hkepc-project/Noise-Meter/hardware/README.md

This repository contains a Noise Meter project from the following link:

http://www.hkepc.com/forum/viewthread.php?fid=146&tid=2419038&extra=page%3D1

The hardware and associated materials (excluding any software) are provided under a [CC BY-SA 4.0](https://creativecommons.org/licenses/by-sa/4.0/) license.
