hkepc-project/Noise-Meter/(list of files, cad)

Other CAD files:
software/PIC/Noise Meter/dist/default/production/Noise_Meter.production.obj
