hkepc-project/Noise-Meter/hardware/Noise Meter.kicad_pcb

## KiCad design hardware/Noise Meter.kicad_pcb (2018-01-29)

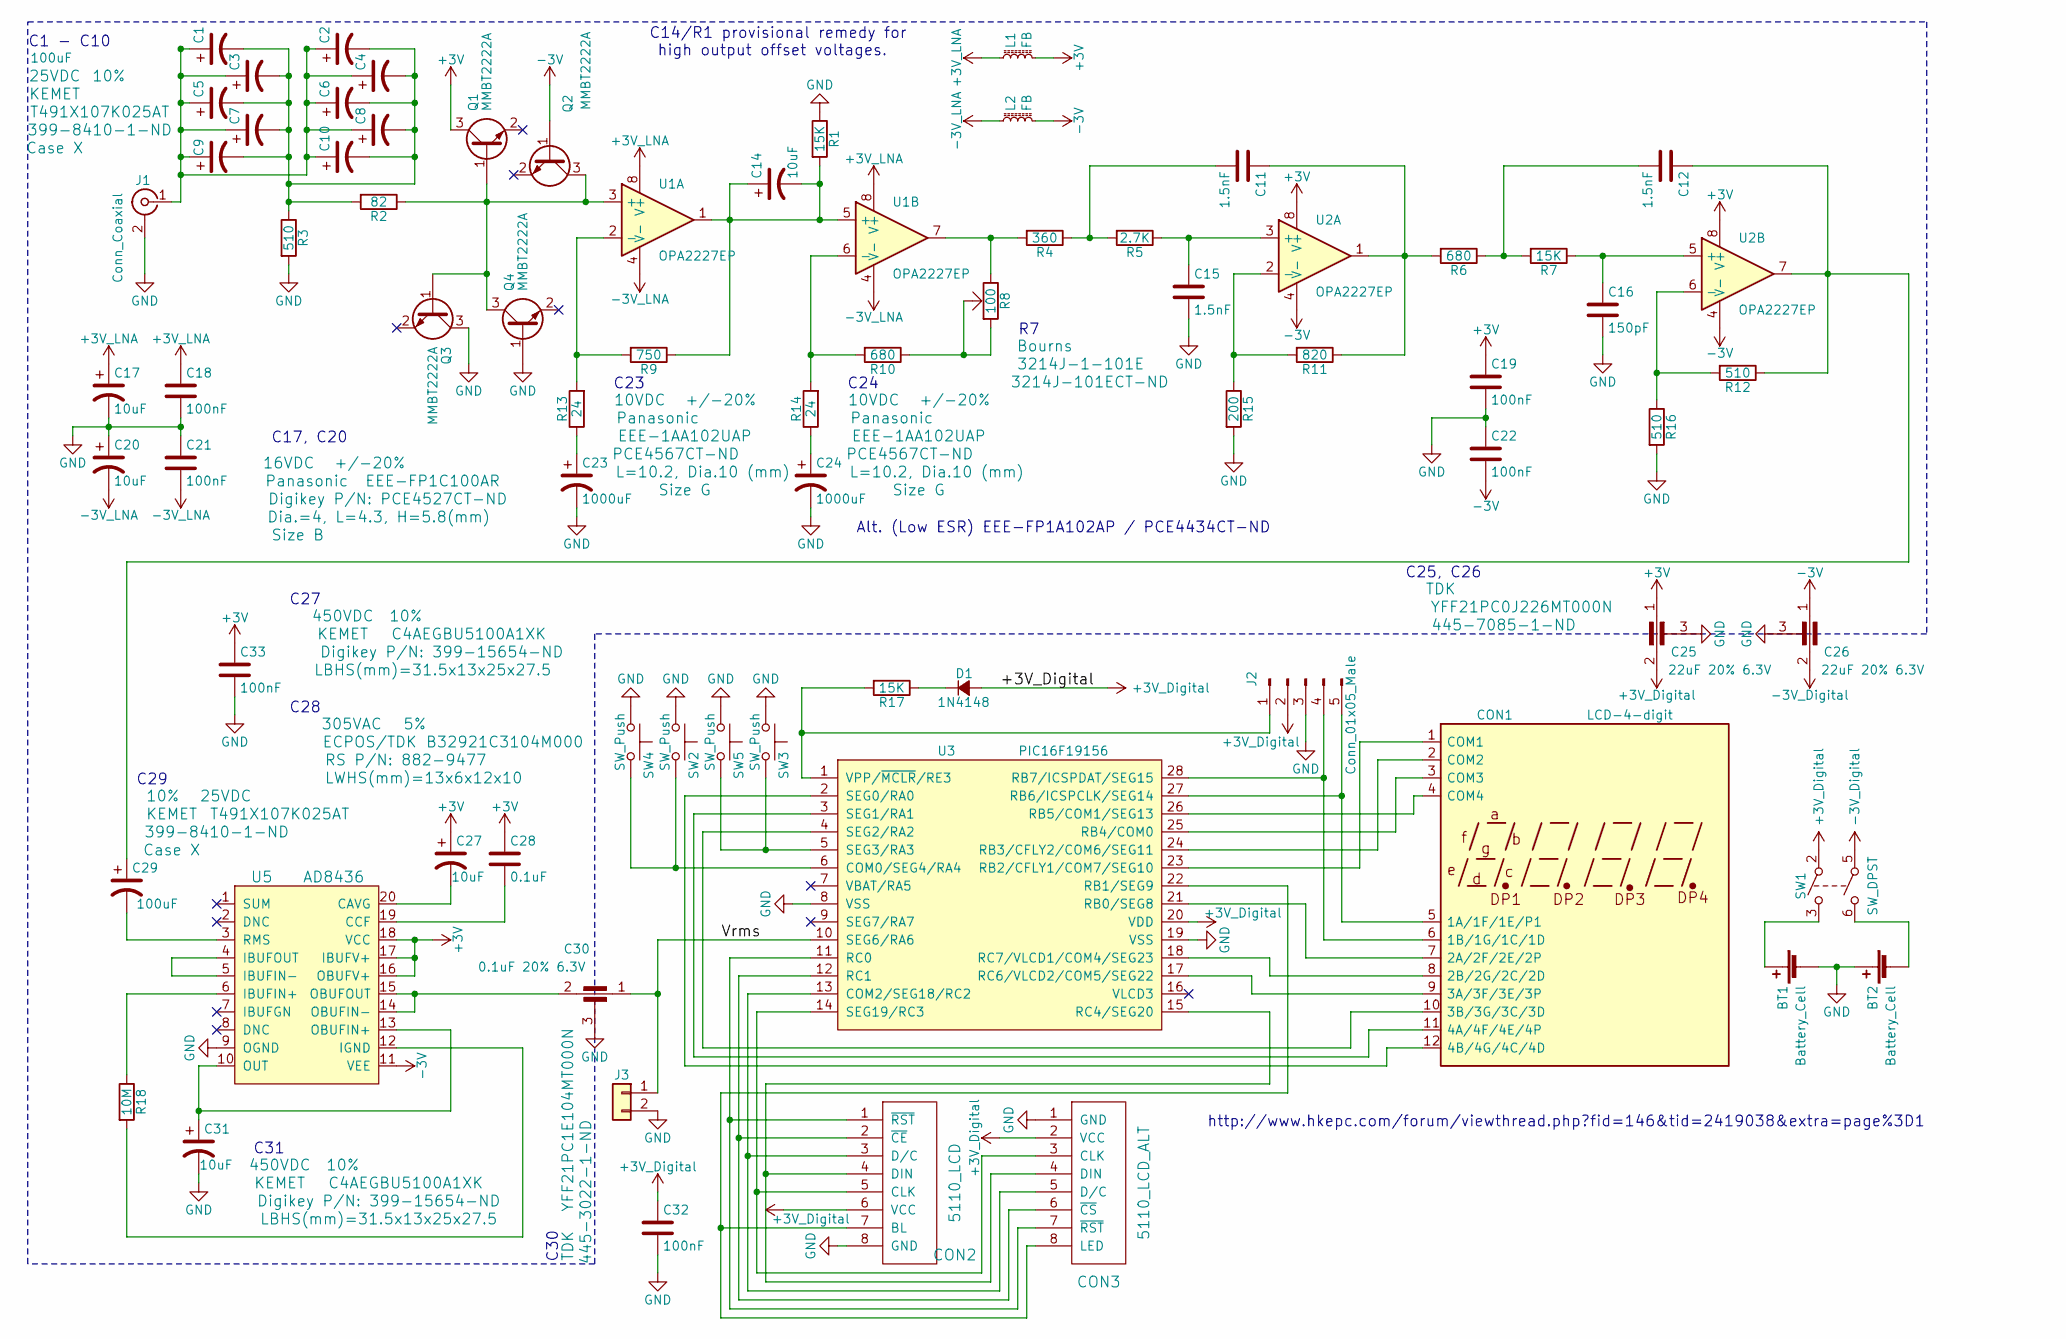
[picture p1: schematic Noise Meter.sch]

Parts:
BT1, BT2: Battery_Cell; Keystone_1058_1x2032-CoinCell
C1, C2, C3, C4, C5, C6, C7, C8, C9, C10, C29: 100uF; CP_Tantalum_Case-X_EIA-7343-43_Hand; Tolerance 10%; Voltage 25VDC; Manufacturer P/N T491X107K025AT; Digikey P/N 399-8410-1-ND
C11, C12, C15: 1.5nF; C_0603_HandSoldering
C14, C17, C20: 10uF; CP_Elec_4x4.5; Voltage 16VDC; Tolerance +/-20%; Manufacturer P/N EEE-FP1C100AR; Digikey P/N Digikey P/N: PCE4527CT-ND
C16: 150pF; C_0603_HandSoldering
C18, C19, C21, C22, C32, C33: 100nF; C_0603_HandSoldering
C23, C24: 1000uF; CP_Elec_10x10.5; Voltage 10VDC; Tolerance +/-20%; Manufacturer P/N EEE-1AA102UAP; Digikey P/N PCE4567CT-ND
C25, C26: 22uF 20% 6.3V; Feedthrough_C_0805_HandSoldering; Manufacturer P/N YFF21PC0J226MT000N; Digikey P/N 445-7085-1-ND
C27, C31: 10uF; C_Rect_L31.5mm_W13.0mm_P27.50mm_MKS4; Tolerance 10%; Voltage 450VDC; Manufacturer P/N C4AEGBU5100A1XK; Digikey P/N Digikey P/N: 399-15654-ND
C28: 0.1uF; C_Rect_L13.0mm_W6.0mm_P10.00mm_FKS3_FKP3_MKS4; Voltage 305VAC; Tolerance 5%
C30: 0.1uF 20% 6.3V; Feedthrough_C_0805_HandSoldering; Manufacturer P/N YFF21PC1E104MT000N; Digikey P/N 445-3022-1-ND
CON1: LCD-4-digit; 4-digit-LCD-footprint
CON2: 5110_LCD; 5110
CON3: 5110_LCD_ALT; 5110-Alt
D1: 1N4148; D_SOD-123
J1: Conn_Coaxial; SMA-CONN
J2: Conn_01x05_Male; Pin_Header_Angled_1x05_Pitch2.54mm
J3: Conn_01x02; Pin_Header_Angled_1x02_Pitch2.54mm
L1, L2: FB; L_0805
Q1, Q2, Q3, Q4: MMBT2222A; SOT-23
R1, R7, R17: 15K; R_0603_HandSoldering
R2: 82; R_0603_HandSoldering
R3, R12, R16: 510; R_0603_HandSoldering
R4: 360; R_0603_HandSoldering
R5: 2.7K; R_0603_HandSoldering
R6, R10: 680; R_0603_HandSoldering
R8: 100; Potentiometer_Trimmer_Bourns_3214J; Manufacturer P/N 3214J-1-101E; Digikey P/N 3214J-101ECT-ND
R9: 750; R_0603_HandSoldering
R11: 820; R_0603_HandSoldering
R13, R14: 24; R_0603_HandSoldering
R15: 200; R_0603_HandSoldering
R18: 10M; R_0603_HandSoldering
SW1: SW_DPST; SW_CuK_JS202011AQN_DPDT_Angled
SW2, SW3, SW4, SW5: SW_Push; SW_SPST_B3SL-1002P
U1, U2: OPA2227EP; SOIC-8-N
U3: PIC16F19156; SSOP-28_5.3x10.2mm_Pitch0.65mm
U5: AD8436; SSOP-20

Connections:
+3V: C19.1, C25.1, C27.1, C28.1, C33.1, L1.2, Q1.3 (C), U2.8 (V+), U5.16 (OBUFV+), U5.17 (IBUFV+), U5.18 (VCC)
+3V_Digital: C25.2, C32.1, CON2.6 (VCC), CON3.2 (VCC), D1.2 (A), J2.2, SW1.2, U3.20 (VDD)
+3V_LNA: C17.1, C18.1, L1.1, U1.8 (V+)
-3V: C22.2, C26.1, L2.2, Q2.1 (B), U2.4 (V-), U5.11 (VEE)
-3V_Digital: C26.2, SW1.5
-3V_LNA: C20.2, C21.2, L2.1, U1.4 (V-)
/Vrms: C30.1, J3.1, U3.10 (SEG6/RA6)
GND: BT1.2 (-), BT2.1 (+), C15.2, C16.2, C17.2, C18.2, C19.2, C20.1, C21.1, C22.1, C23.2, C24.2, C25.3, C26.3, C30.3, C31.2, C32.2, C33.2, CON2.8 (GND), CON3.1 (GND), J1.2 (Ext), J2.3, J3.2, Q3.3 (C), Q4.1 (B), R1.1, R3.2, R15.2, R16.2, SW2.1, SW3.1, SW4.1, SW5.1, U3.8 (VSS), U3.19 (VSS), U5.9 (OGND)
unnamed: BT1.1 (+), SW1.3
unnamed: BT2.2 (-), SW1.6
unnamed: C1.1, C2.1, C3.1, C4.1, C5.1, C6.1, C7.1, C8.1, C9.1, C10.1, J1.1 (In)
unnamed: C1.2, C2.2, C3.2, C4.2, C5.2, C6.2, C7.2, C8.2, C9.2, C10.2, R2.2, R3.1
unnamed: C11.1, R6.2, R11.1, U2.1
unnamed: C11.2, R4.1, R5.2
unnamed: C12.1, C29.1, R12.1, U2.7
unnamed: C12.2, R6.1, R7.2
unnamed: C14.1, C14.2, R1.2, R9.1, U1.1, U1.5 (+)
unnamed: C15.1, R5.1, U2.3 (+)
unnamed: C16.1, R7.1, U2.5 (+)
unnamed: C23.1, R13.1
unnamed: C24.1, R14.1
unnamed: C27.2, U5.20 (CAVG)
unnamed: C28.2, U5.19 (CCF)
unnamed: C29.2, U5.3 (RMS)
unnamed: C30.2, U5.14 (OBUFIN-), U5.15 (OBUFOUT)
unnamed: C31.1, U5.10 (OUT), U5.13 (OBUFIN+)
unnamed: CON1.1 (COM1), U3.23 (RB2/CFLY1/COM7/SEG10)
unnamed: CON1.2 (COM2), U3.24 (RB3/CFLY2/COM6/SEG11)
unnamed: CON1.3 (COM3), U3.25 (RB4/COM0)
unnamed: CON1.4 (COM4), U3.26 (RB5/COM1/SEG13)
unnamed: CON1.5 (1A/1F/1E/P1), J2.5, U3.27 (RB6/ICSPCLK/SEG14)
unnamed: CON1.6 (1B/1G/1C/1D), J2.4, U3.28 (RB7/ICSPDAT/SEG15)
unnamed: CON1.7 (2A/2F/2E/2P), U3.21 (RB0/SEG8)
unnamed: CON1.8 (2B/2G/2C/2D), U3.18 (RC7/VLCD1/COM4/SEG23)
unnamed: CON1.9 (3A/3F/3E/3P), U3.17 (RC6/VLCD2/COM5/SEG22)
unnamed: CON1.10 (3B/3G/3C/3D), U3.4 (SEG2/RA2)
unnamed: CON1.11 (4A/4F/4E/4P), U3.3 (SEG1/RA1)
unnamed: CON1.12 (4B/4G/4C/4D), U3.2 (SEG0/RA0)
unnamed: CON2.1 (~RST), CON3.7 (~RST), U3.11 (RC0)
unnamed: CON2.2 (~CE), CON3.6 (~CS), U3.12 (RC1)
unnamed: CON2.3 (D/C), CON3.5 (D/C), U3.13 (COM2/SEG18/RC2)
unnamed: CON2.4 (DIN), CON3.4 (DIN), U3.15 (RC4/SEG20)
unnamed: CON2.5 (CLK), CON3.3 (CLK), U3.14 (SEG19/RC3)
unnamed: CON2.7 (BL), CON3.8 (LED), U3.22 (RB1/SEG9)
unnamed: D1.1 (K), R17.1
unnamed: J2.1, R17.2, U3.1 (VPP/~MCLR~/RE3)
unnamed: Q1.1 (B), Q2.3 (C), Q3.1 (B), Q4.3 (C), R2.1, U1.3 (+)
unnamed: R4.2, R8.1, U1.7
unnamed: R8.2, R8.3, R10.1
unnamed: R10.2, R14.2, U1.6 (-)
unnamed: R11.2, R15.1, U2.2 (-)
unnamed: R12.2, R16.1, U2.6 (-)
unnamed: R9.2, R13.2, U1.2 (-)
unnamed: R18.1, U5.6 (IBUFIN+)
unnamed: R18.2, U5.12 (IGND)
unnamed: SW2.2, SW4.2, U3.6 (COM0/SEG4/RA4)
unnamed: SW3.2, SW5.2, U3.5 (SEG3/RA3)
unnamed: U5.4 (IBUFOUT), U5.5 (IBUFIN-)

Notes on the sheet:
C27
C28
C29
Alt. (Low ESR) EEE-FP1A102AP / PCE4434CT-ND
C17, C20
C31
C24
C23
C25, C26
C30
C1 - C10
C14/R1 provisional remedy for high output offset voltages.
http://www.hkepc.com/forum/viewthread.php?fid=146&tid=2419038&extra=page%3D1

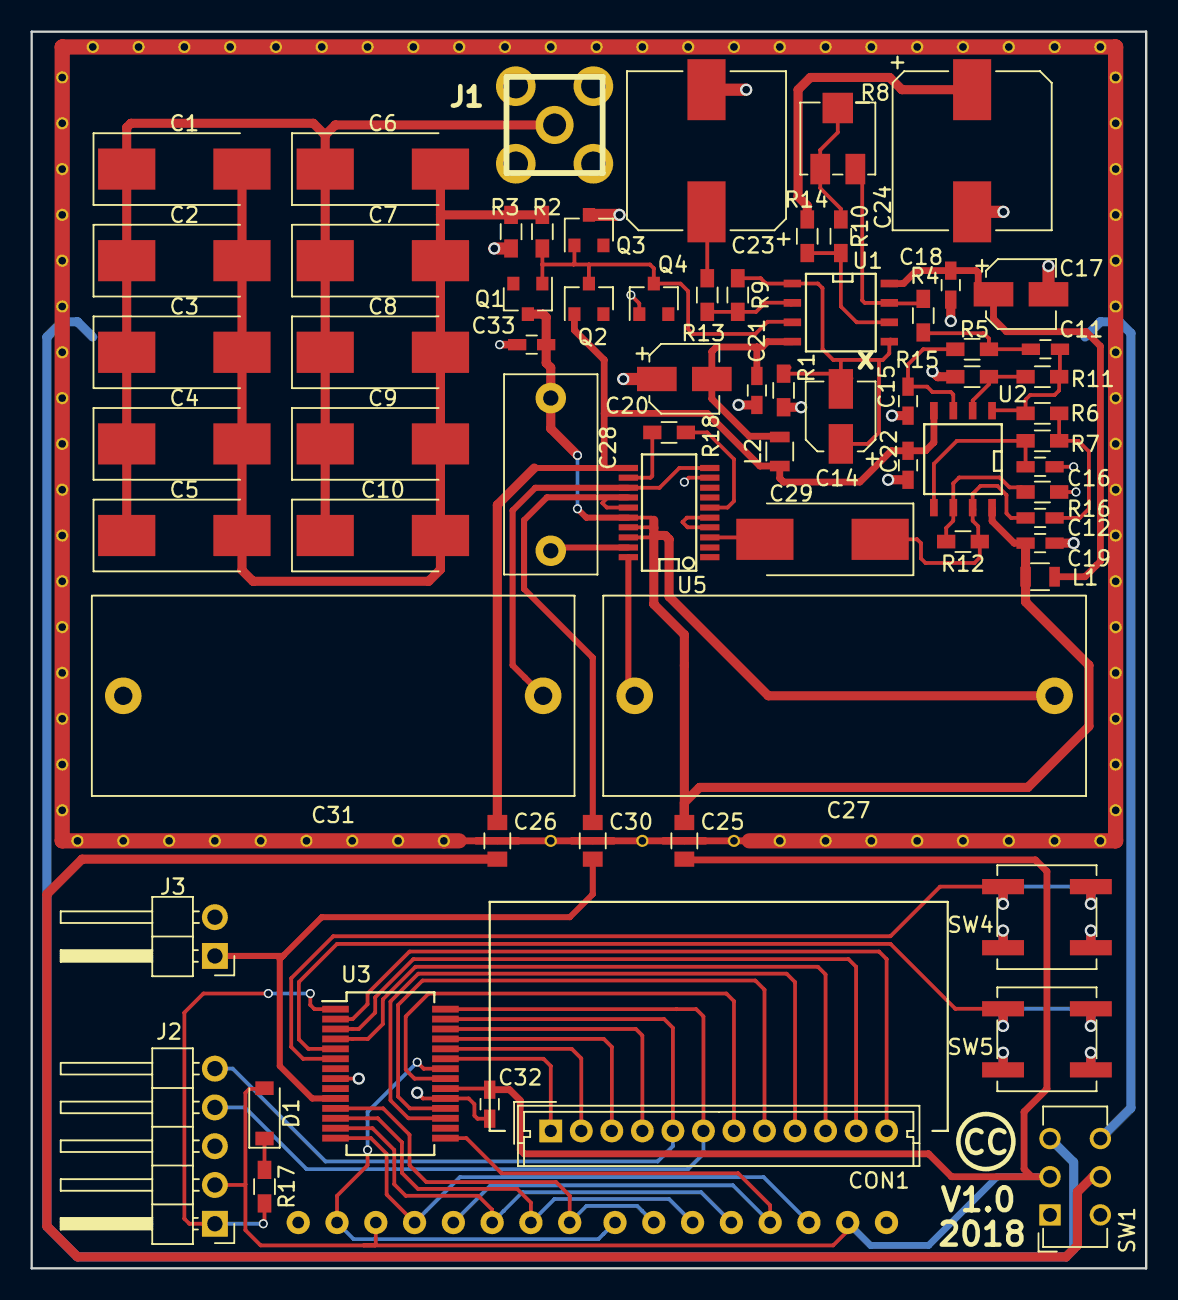
[picture p2: board Noise Meter.kicad_pcb from above]

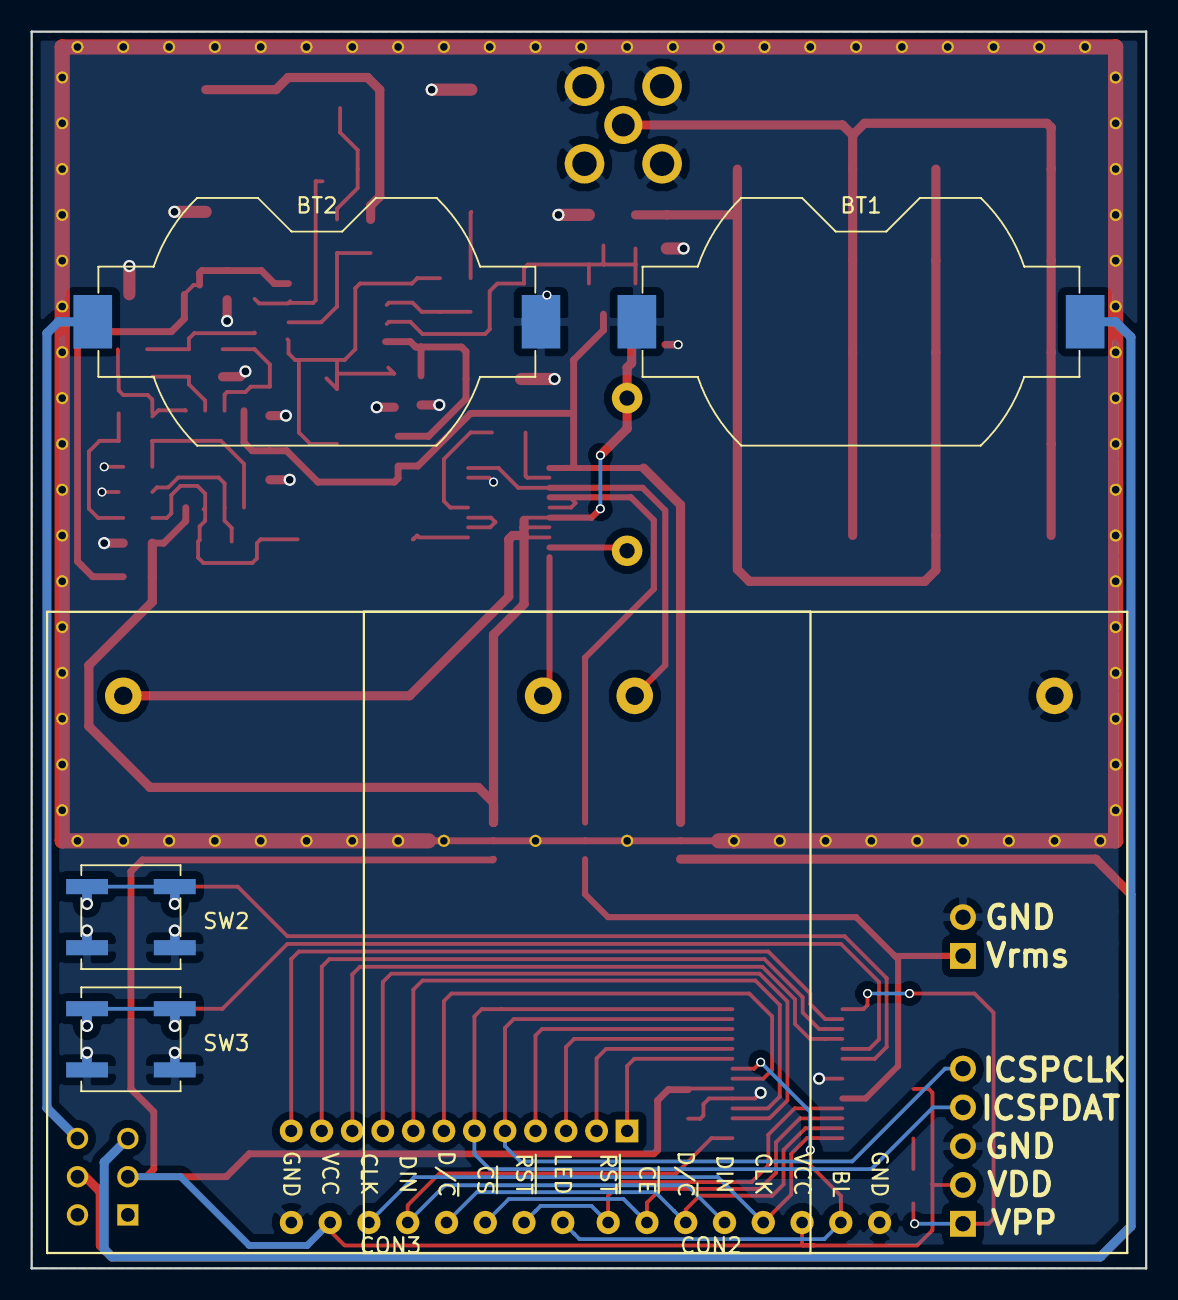
[picture p3: board Noise Meter.kicad_pcb from below]

Board: 2 copper layers, 73.0 x 81.0 mm, 74 parts (6 on the bottom side), 58 nets.
