hkepc-project/Noise-Meter/software/PIC/Noise Meter/main.c

/**
  Generated Main Source File

  Company:
    Microchip Technology Inc.

  File Name:
    main.c

  Summary:
    This is the main file generated using PIC10 / PIC12 / PIC16 / PIC18 MCUs

  Description:
    This header file provides implementations for driver APIs for all modules selected in the GUI.
    Generation Information :
        Product Revision  :  PIC10 / PIC12 / PIC16 / PIC18 MCUs - 1.65
        Device            :  PIC16F19156
        Driver Version    :  2.00
*/

/*
    (c) 2016 Microchip Technology Inc. and its subsidiaries. You may use this
    software and any derivatives exclusively with Microchip products.

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
    IN NO EVENT WILL MICROCHIP BE LIABLE FOR ANY INDIRECT, SPECIAL, PUNITIVE,
    INCIDENTAL OR CONSEQUENTIAL LOSS, DAMAGE, COST OR EXPENSE OF ANY KIND
    WHATSOEVER RELATED TO THE SOFTWARE, HOWEVER CAUSED, EVEN IF MICROCHIP HAS
    BEEN ADVISED OF THE POSSIBILITY OR THE DAMAGES ARE FORESEEABLE. TO THE
    FULLEST EXTENT ALLOWED BY LAW, MICROCHIP'S TOTAL LIABILITY ON ALL CLAIMS IN
    ANY WAY RELATED TO THIS SOFTWARE WILL NOT EXCEED THE AMOUNT OF FEES, IF ANY,
    THAT YOU HAVE PAID DIRECTLY TO MICROCHIP FOR THIS SOFTWARE.

    MICROCHIP PROVIDES THIS SOFTWARE CONDITIONALLY UPON YOUR ACCEPTANCE OF THESE
    TERMS.
*/

#include <stdio.h>
#include "mcc_generated_files/mcc.h"
#include "main.h"
#include "Nokia_5110.h"
/*
                         Main application
 */

int state=0;


 void main(void)
{
    // initialize the device
    SYSTEM_Initialize();

    // When using interrupts, you need to set the Global and Peripheral Interrupt Enable bits
    // Use the following macros to:
    
    
    
    LCD_BL_SetLow();
                
                
                
    char    str_greeting[]="NOISE METER\n";
    nokia_init();   
    nokia_clean_buffer();
    nokia_gotoxy(8,0);
    nokia_printstr(&str_greeting[0]);
    nokia_refresh();
    
 /*   
    
    float ff=1.245f;
    int ii=334;
    char sbuf[20];
    sprintf(&sbuf[0],"%f",ff);
    nokia_gotoxy(0,2);
    nokia_printstr(&sbuf[0]);
    nokia_refresh();
    
*/


    
    // Enable the Global Interrupts
   INTERRUPT_GlobalInterruptEnable();

    // Enable the Peripheral Interrupts
   INTERRUPT_PeripheralInterruptEnable();

    // Disable the Global Interrupts
    //INTERRUPT_GlobalInterruptDisable();

    // Disable the Peripheral Interrupts
    //INTERRUPT_PeripheralInterruptDisable();
    

    
    int i=0;
    while (1)
    {
        // Add your application code
    
        
        i++;
        if (i>=1000) i=0;
        
//        RB1=0;
//       __delay_ms(900);
//        RB1=1;
//       __delay_ms(100);

//        if (state==0) {
//        IO_RB1_SetLow();
//            state=1;
//           __delay_ms(900);
//        } else {
//        IO_RB1_SetHigh();
//            state=0;
//           __delay_ms(900);
//        }
    }
}
/**
 End of File
*/
