hkepc-project/Noise-Meter/software/PIC/Noise Meter/main.h

/* 
 * File:   main.h
 * Author: hugoc_000
 *
 * Created on 2018?03?25? ???, ??9:43
 */

#ifndef MAIN_H
#define	MAIN_H

#ifdef	__cplusplus
extern "C" {
#endif




#ifdef	__cplusplus
}
#endif
/*
#define LCD_RST RC0
#define LCD_CE  RC1
#define LCD_DC  RC2
#define LCD_CLK RC3
#define LCD_DIN RC4
#define LCD_BL   RB1
*/




#endif	/* MAIN_H */
