hkepc-project/Noise-Meter/software/PIC/Noise Meter/xmain.c

/* 
 * File:   main.c
 * Author: hugoc_000
 *
 * Created on 2018?03?25? ???, ??9:43
 */

#include <stdio.h>
#include <stdlib.h>


#include "main.h"
#include "..mcc.h"

/*
 * 
 */
int main(int argc, char** argv) {
    SYSTEM_Initialize();
    return (EXIT_SUCCESS);
}
