hkepc-project/Noise-Meter/(commit log)

2018-01-20 ready for pcb layout
    [Noise Meter.kicad_pcb, Noise Meter.sch]
2018-01-27 PCB V1.0
    [Noise Meter - via stiching backup .kicad_pcb, Noise Meter digital backup.kicad_pcb, Noise Meter.kicad_pcb, Noise Meter.sch, noname.kicad_pcb-test.kicad_pcb]
2018-01-27 final touch ups and gerber files added
    [Noise Meter-B.Cu.gbr, Noise Meter-B.Mask.gbr, Noise Meter-B.SilkS.gbr, Noise Meter-Edge.Cuts.gbr, Noise Meter-F.Cu.gbr, Noise Meter-F.Mask.gbr, Noise Meter-F.SilkS.gbr, Noise Meter.drl]
2018-01-29 first pcb fabrication version
    [Noise Meter-B.Cu.gbr, Noise Meter-B.Mask.gbr, Noise Meter-B.SilkS.gbr, Noise Meter-Edge.Cuts.gbr, Noise Meter-F.Cu.gbr, Noise Meter-F.Mask.gbr, Noise Meter-F.SilkS.gbr, Noise Meter.drl]
2018-04-25 ADC testing in porgress...
    [Noise Meter BOM backup.csv, Noise Meter BOM backup.ods, Noise_Meter.production.obj]
2018-04-25 First Working Version
    [Noise_Meter.production.obj]
